SEEK-Academy/sun-sensor-hardware/doc/components/PCB 50x70 v3 (2).png

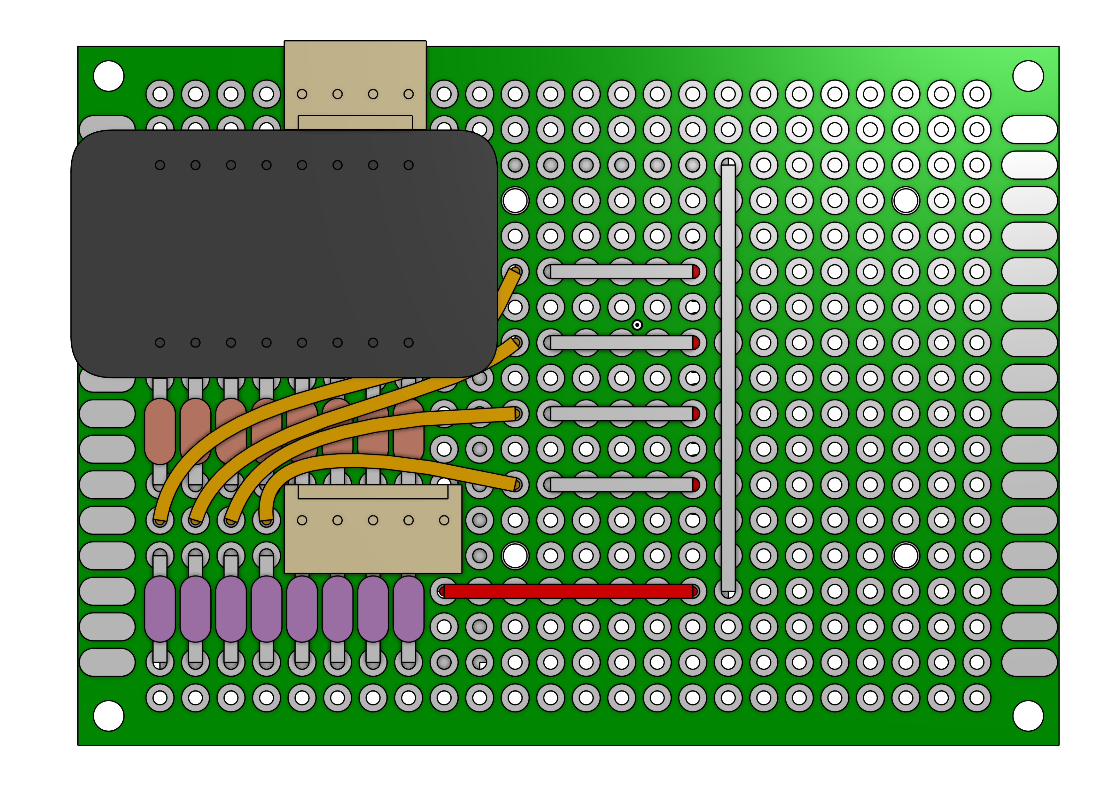
doc/components/PCB 50x70 v3 (2).png
