SEEK-Academy/sun-sensor-hardware/doc/components/PCB 40x60 FR v1 (2).png

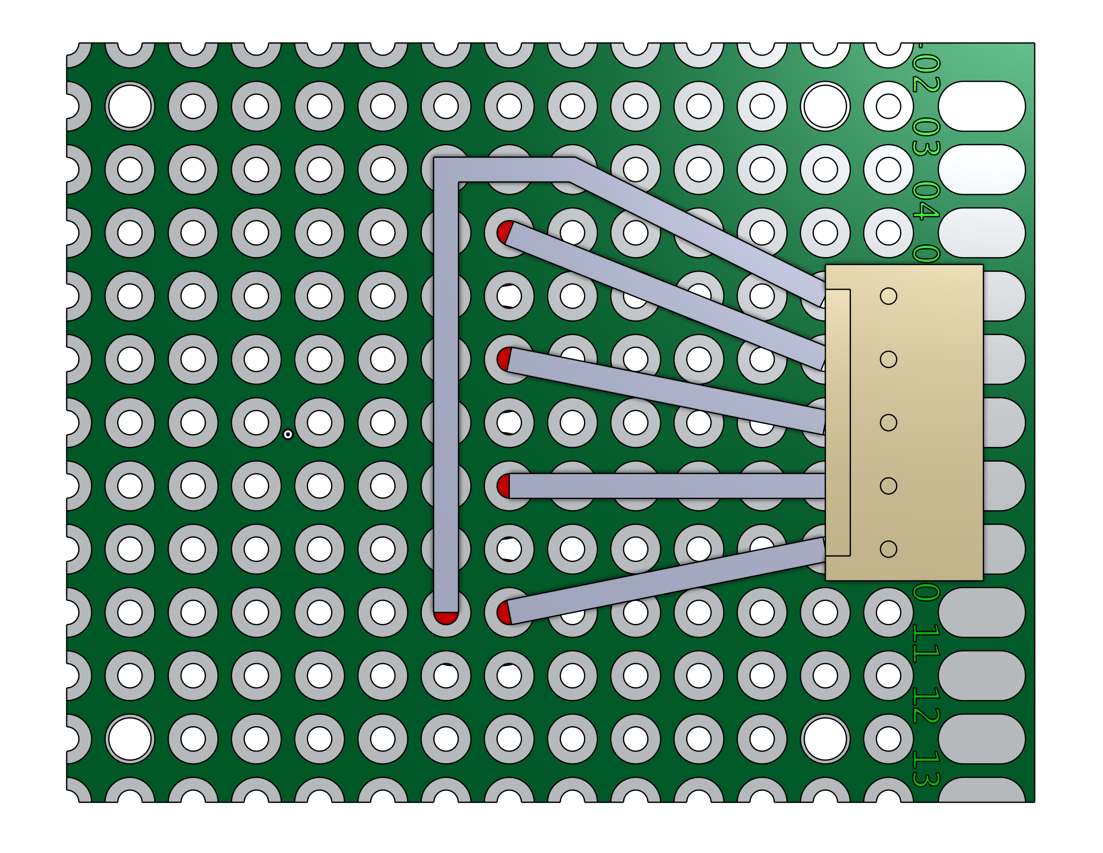
doc/components/PCB 40x60 FR v1 (2).png
