SEEK-Academy/sun-sensor-hardware/doc/3D_models/Calculation.xlsx

Sheet: Face
VERSION 2-3
Name | Symbol | Value | Unit |  |  |  | Photoresistor | From | Center | To | Unit
sensor length | Lp | 4.5 | mm |  |  |  | 1 | -9 | -6.75 | -4.5 | mm
sensor width | Wp | 5.2 | mm |  |  |  | 2 | -4.5 | -2.25 | 0 | mm
sensor number | N | 4 | pieces |  |  |  | 3 | 0 | 2.25 | 4.5 | mm
sensor array length | L | 18 | mm |  |  |  | 4 | 4.5 | 6.75 | 9 | mm
maximum distance from center to edge of array | dmax | 9 | mm
space between array and slit | h | 9 | mm
slit length | b | 18 | mm
slit width | a | 6.75 | mm
slit height | c | 0.2 | mm | < | 6.75 | mm
VERSION 4-…
Name | Symbol | Value | Unit |  |  |  | Photoresistor | From | Center | To | Unit
sensor length | Lp | 4.5 | mm |  |  |  | 1 | -9 | -6.75 | -4.5 | mm
sensor width | Wp | 5.2 | mm |  |  |  | 2 | -4.5 | -2.25 | 0 | mm
sensor number | N | 4 | pieces |  |  |  | 3 | 0 | 2.25 | 4.5 | mm
sensor array length | L | 18 | mm |  |  |  | 4 | 4.5 | 6.75 | 9 | mm
maximum distance from center to edge of array | dmax | 9 | mm
space between array and slit | h | 9 | mm |  |  |  | Bolt size | Size | Length S | Length L | Unit
slit length | b | 18 | mm |  |  |  | - | M3 | 10 | 20 | mm
slit width | a | 5.4 | mm |  |  |  | Nut size | Borders | Height | Width | Length | Unit
slit height | c | 0.2 | mm | < | 5.4 | mm | - | 6 | 2.4 | 5.4 | 6 | mm
VERSION 8-…
Name | Symbol | Value | Unit |  |  |  | Photoresistor | From | Center | To | Unit |  | Board raster | unit |  | Value | Unit
sensor length (max) | Lp | 4.5 | mm |  |  |  | 1 | -9.87 | -7.62 | -5.37 | mm |  | 2.54 | mm | Face height | 2 | mm
sensor width (max) | Wp | 5.2 | mm |  |  |  | 2 | -4.79 | -2.54 | -0.29 | mm |  |  |  | Separator slot | 0.4 | mm
sensor number | N | 4 | pieces |  |  |  | 3 | 0.29 | 2.54 | 4.79 | mm |  |  |  | Separator height | 10.57 | mm
sensor array length | L | 19.74 | mm |  |  |  | 4 | 5.37 | 7.62 | 9.87 | mm |  | Sensor height (avg) | unit | From face bottom to array | 7.87 | mm
maximum distance from center to edge of array | dmax | 9.87 | mm |  |  |  |  |  |  |  |  |  | 2.1 | mm | From face bottom to board | 10.17 | mm
space between array and slit | h | 9.87 | mm |  |  |  | Bolt size | Size | Length | Width | Unit |  | Sensor spacing to board |  | From separator slot to array | 7.47 | mm
slit length | b | 19.74 | mm |  |  |  | - | M1.6 | 16 | 1.3 | mm |  | 0.2 | mm | From separator slot to board | 9.77 | mm
slit width | a | 3.6 | mm |  |  |  | Nut size | Borders | Height | Width | Length | Unit | Sensor height to board |  | From face top to array | 9.87 | mm
slit height | c | 0.2 | mm | < | 2.222530646 | mm | - | 6 | 1.1 | 3 | 3.4 | mm | 2.3 | mm | From face top to board | 12.17 | mm

Sheet: Platform
VERSION 1-…
Circuit board |  |  | Spacing bettwen Circuit board and Platform slit |  |  |  | Platform slit |  |  | Circuit board support stand |  |  |  |  | Empty slit
Dimension | Value | Unit | Projection | Site | Value | Unit | Dimension | Value | Unit | Projection | Site | Value | Unit |  | Dimension | Value | Unit
Length | 51 | mm | Top | Top | 1 | mm | Length | 53 | mm | Top | Top | 0 | mm |  | Length | 51 | mm
Width | 51 | mm | Top | Bottom | 1 | mm | Width | 53 | mm | Top | Bottom | 0 | mm |  | Width | 48.6 | mm
Height | 1.2 | mm | Top | Right | 1 | mm | Height | 1.2 | mm | Top | Right | 1.2 | mm |  | Height | - | mm
 |  |  | Top | Left | 1 | mm |  |  |  | Top | Left | 1.2 | mm
 |  |  | Front | Top | 0 | mm
 |  |  | Front | Bottom | 0 | mm
VERSION 3-…
Circuit board |  |  | Spacing bettwen Circuit board and Platform slit |  |  |  | Platform slit |  |  | Circuit board support stand |  |  |  | Platform board thickness |  |  |  | Platform size
Dimension | Value | Unit | Projection | Site | Value | Unit | Dimension | Value | Unit | Dimension | Value | Unit |  | Projection | Site | Value | Unit | Dimension | Value | Unit
Length | 54 | mm | Top | Top | 0 | mm | Length | 54 | mm | Height | 0.8 | mm |  | Top | Top | 1 | mm | Length | 56 | mm
Width | 51 | mm | Top | Bottom | 0 | mm | Width | 51 | mm | grid pattern |  |  |  | Top | Bottom | 1 | mm | Width | 56 | mm
Height | 1.2 | mm | Top | Right | 0 | mm | Height | 1.2 | mm |  |  |  |  | Top | Right | 2.5 | mm | Height | 1.2 | mm
 |  |  | Top | Left | 0 | mm |  |  |  |  |  |  |  | Top | Left | 2.5 | mm
 |  |  | Front | Top | 0 | mm
 |  |  | Front | Bottom | 0 | mm
VERSION 4-…
Circuit board |  |  | Spacing bettwen Circuit board and Platform slit |  |  |  | Platform slit |  |  | Circuit board support stand |  |  |  | Platform board thickness |  |  |  | Platform size
Dimension | Value | Unit | Projection | Site | Value | Unit | Dimension | Value | Unit | Dimension | Value | Unit |  | Projection | Site | Value | Unit | Dimension | Value | Unit
Length | 54 | mm | Top | Top | 0 | mm | Length | 54 | mm | Height | 0.8 | mm |  | Top | Top | 1 | mm | Length | 56 | mm
Width | 50 | mm | Top | Bottom | 0 | mm | Width | 50 | mm | grid pattern mechd with pads |  |  |  | Top | Bottom | 1 | mm | Width | 56 | mm
Height | 1.2 | mm | Top | Right | 0 | mm | Height | 1.2 | mm |  |  |  |  | Top | Right | 3 | mm | Height | 2 | mm
 |  |  | Top | Left | 0 | mm |  |  |  |  |  |  |  | Top | Left | 3 | mm
 |  |  | Front | Top | 0 | mm
 |  |  | Front | Bottom | 0 | mm
