SEEK-Academy/sun-sensor-hardware/doc/3D_models/Comparison of photoresist measurements - 20241130.xlsx

MESUREMENTS |  |  |  |  |  | SOURCE MIN-MAX
package | item | length | width | height | unit |  | length | width | height | unit
1 | 1 | 4.1 | 5 | 1.9 | mm | min | 4.1 | 5 | 1.9 | mm
1 | 2 | 4 | 4.9 | 2 | mm | max | 4.5 | 5.2 | 2.3 | mm
1 | 3 | 4.2 | 5 | 1.9 | mm
2 | 4 | 4.2 | 5 | 2.1 | mm | MESUREMENTS MIN-MAX
2 | 5 | 4.1 | 5 | 2.3 | mm |  | length | width | height | unit
2 | 6 | 4.1 | 4.9 | 2.2 | mm | min | 4 | 4.9 | 1.9 | mm
3 | 7 | 4.2 | 5 | 2.2 | mm | max | 4.3 | 5 | 2.3 | mm
3 | 8 | 4.2 | 5 | 2.1 | mm
3 | 9 | 4.3 | 5 | 2.2 | mm
