SEEK-Academy/sun-sensor-hardware/doc/components/PCB 50x70 v3 (1).png

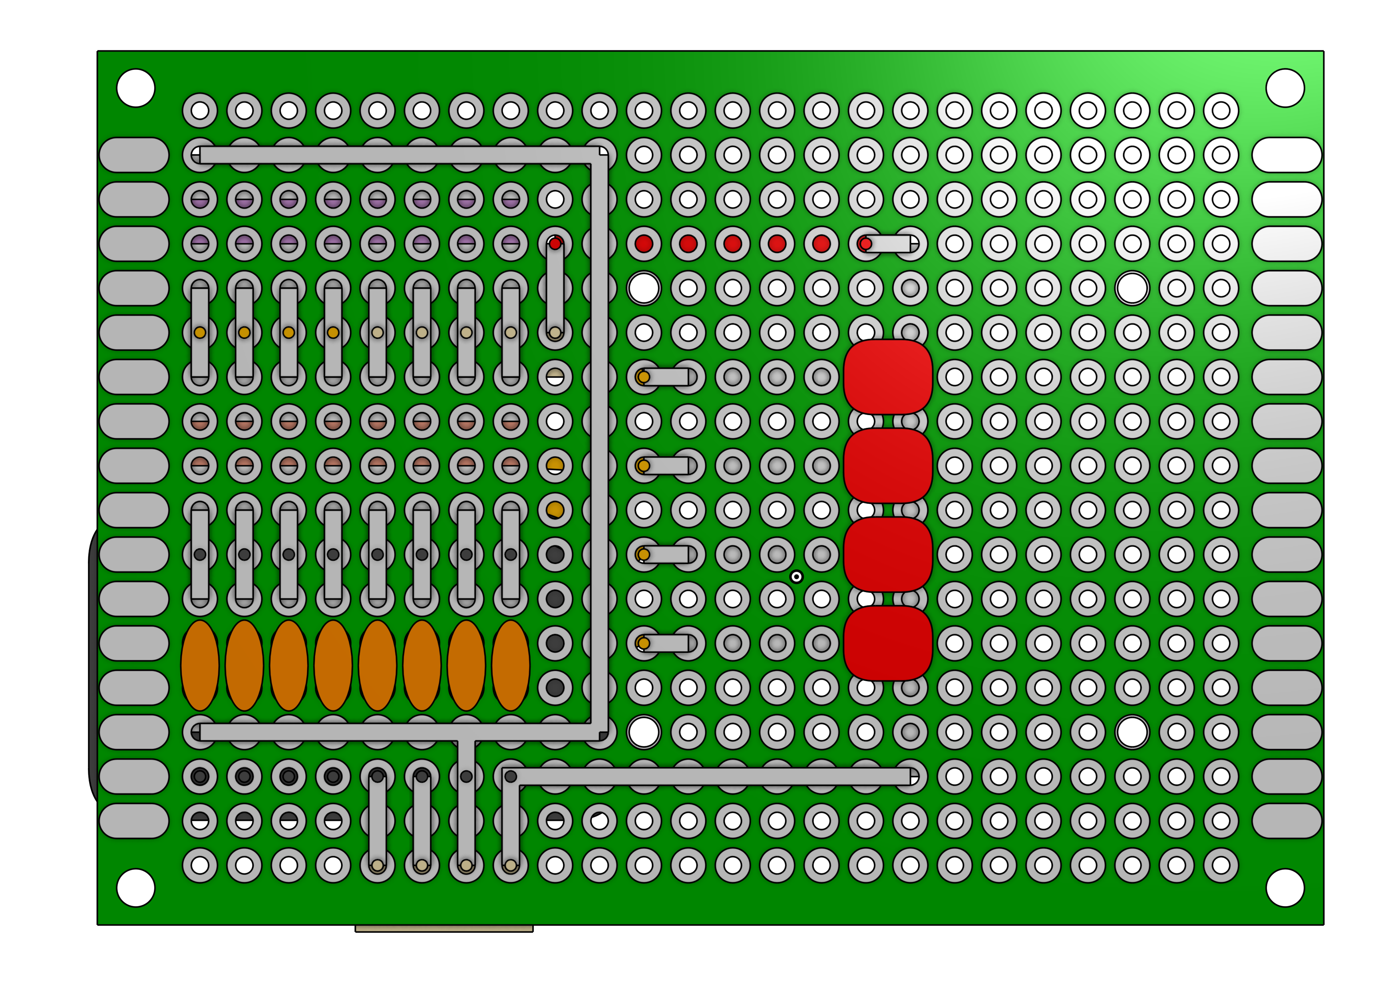
doc/components/PCB 50x70 v3 (1).png
