SEEK-Academy/sun-sensor-hardware/doc/components/PCB 50x70 v3 (2) no ADC.png

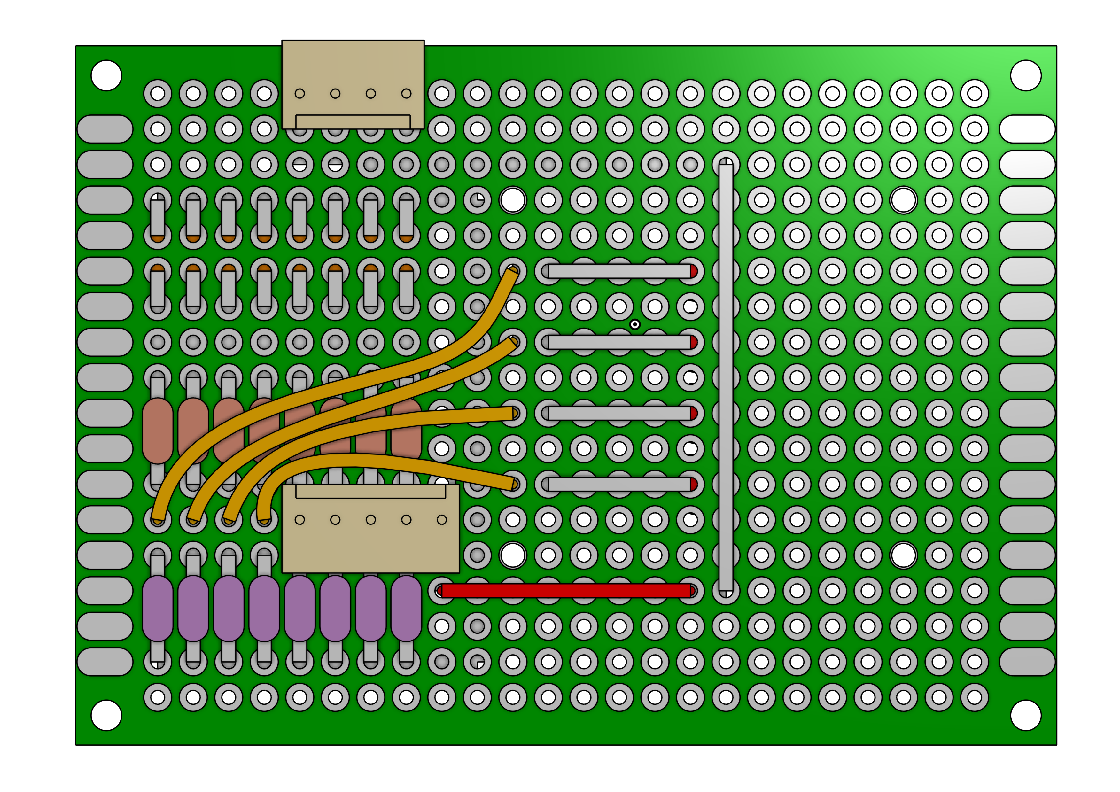
doc/components/PCB 50x70 v3 (2) no ADC.png
