SEEK-Academy/sun-sensor-hardware/doc/components/PCB 50x70 v3 (4).png

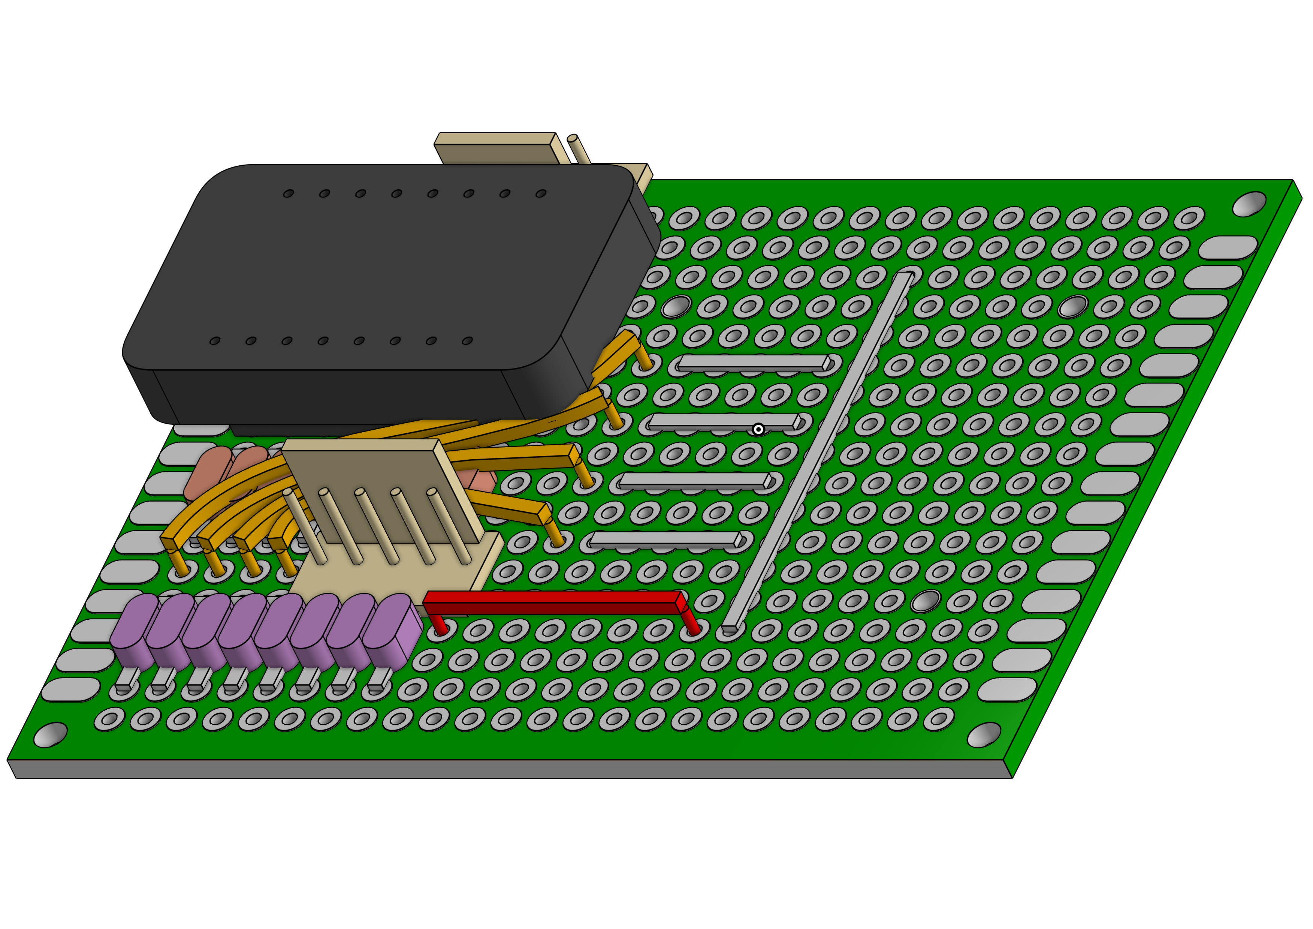
doc/components/PCB 50x70 v3 (4).png
