SEEK-Academy/sun-sensor-hardware/doc/components/PCB 60x80 STM v1 (1).png

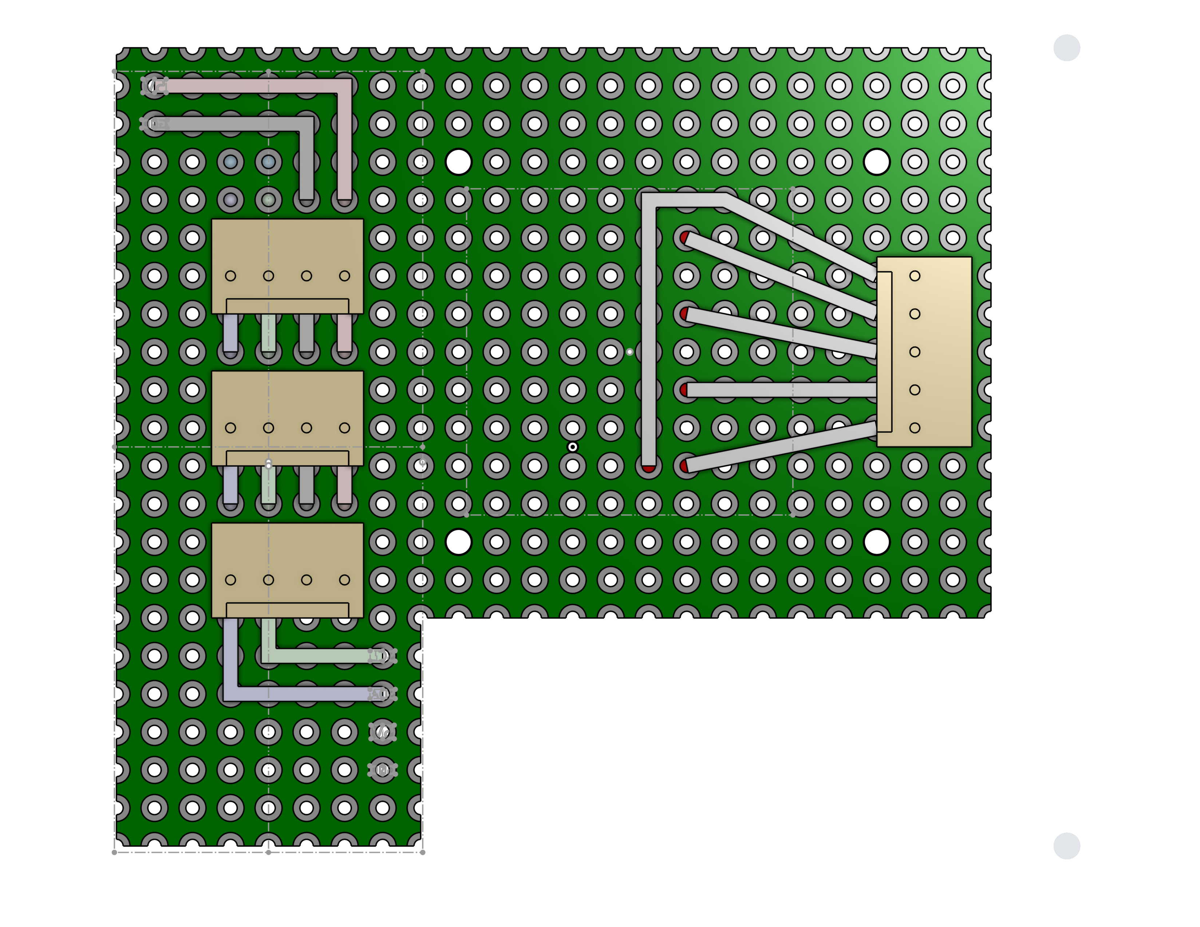
doc/components/PCB 60x80 STM v1 (1).png
