SEEK-Academy/sun-sensor-hardware/doc/3D_models/assemblies/Assembly - 3 faces.stl

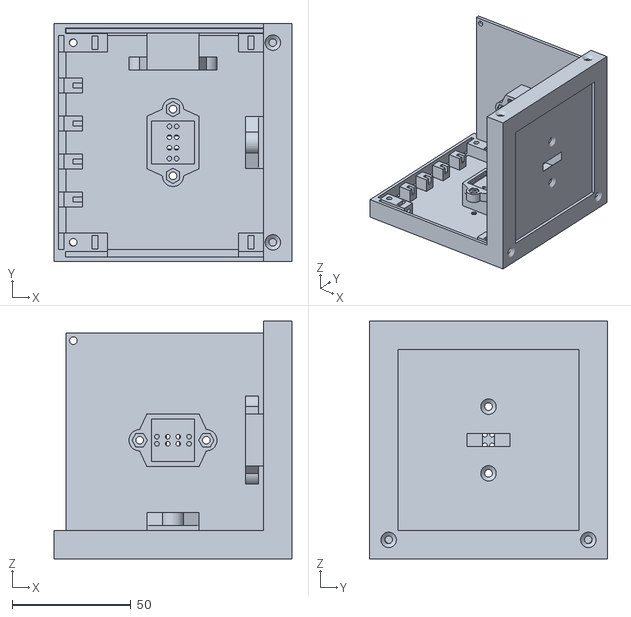
[picture p10: CAD file, 2025-03-29]
doc/3D_models/assemblies/Assembly - 3 faces.stl
100.0 x 100.0 x 100.0
