SEEK-Academy/sun-sensor-hardware/doc/3D_models/assemblies/Assembly - 3 faces and platforms.stl

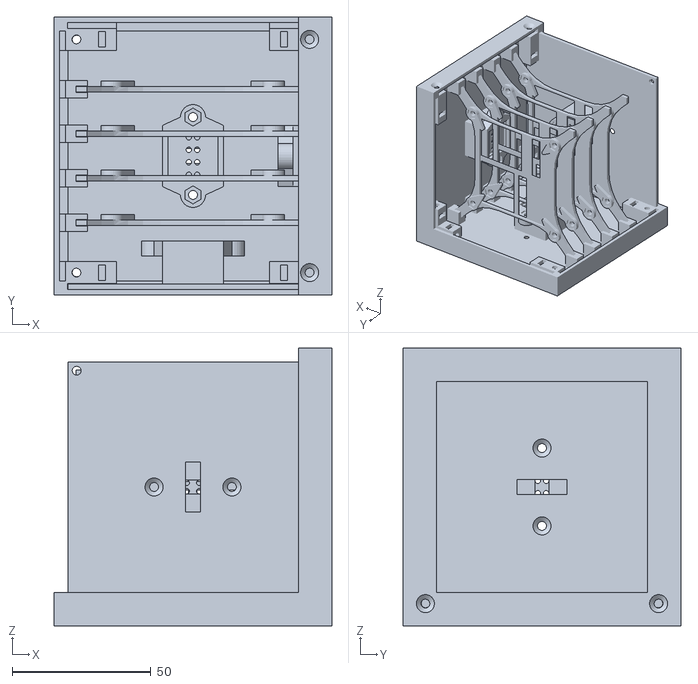
[picture p11: CAD file, 2025-03-29]
doc/3D_models/assemblies/Assembly - 3 faces and platforms.stl
100.0 x 100.0 x 100.0
