SEEK-Academy/sun-sensor-hardware/doc/3D_models/frame_cup/v3/SunSensor - frame cup v3.3mf

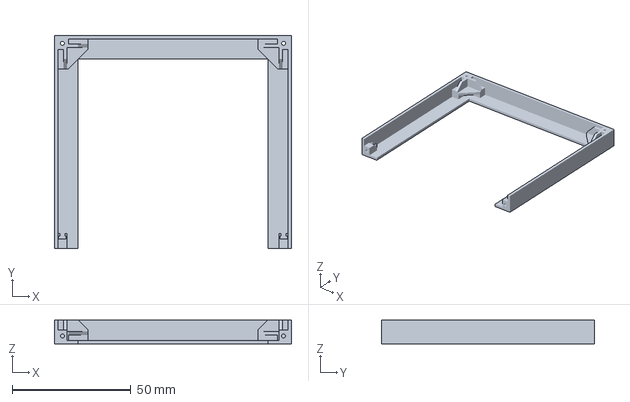
[picture p12: CAD file, 2026-03-20]
doc/3D_models/frame_cup/v3/SunSensor - frame cup v3.3mf
100.0 x 90.0 x 10.0 mm
