SEEK-Academy/sun-sensor-hardware/doc/3D_models/frame_stick/v4/SunSensor - frame stick lid v4_horizontal.3mf

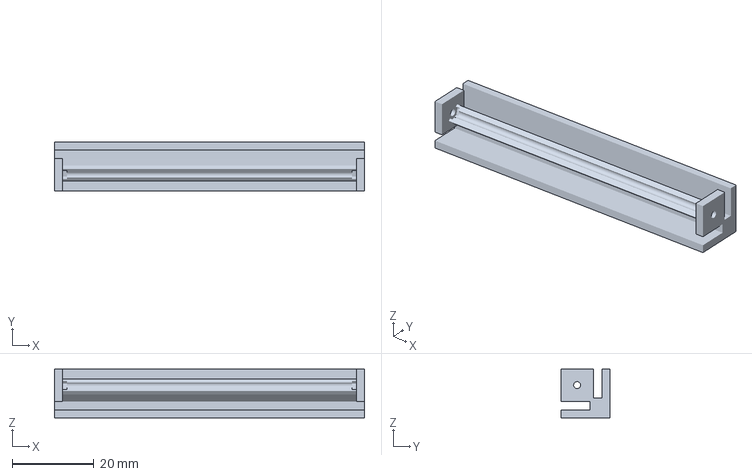
[picture p13: CAD file, 2025-06-09]
doc/3D_models/frame_stick/v4/SunSensor - frame stick lid v4_horizontal.3mf
76.0 x 12.0 x 12.0 mm
