SEEK-Academy/sun-sensor-hardware/doc/3D_models/holder/v1/SunSensor - holder v1.3mf

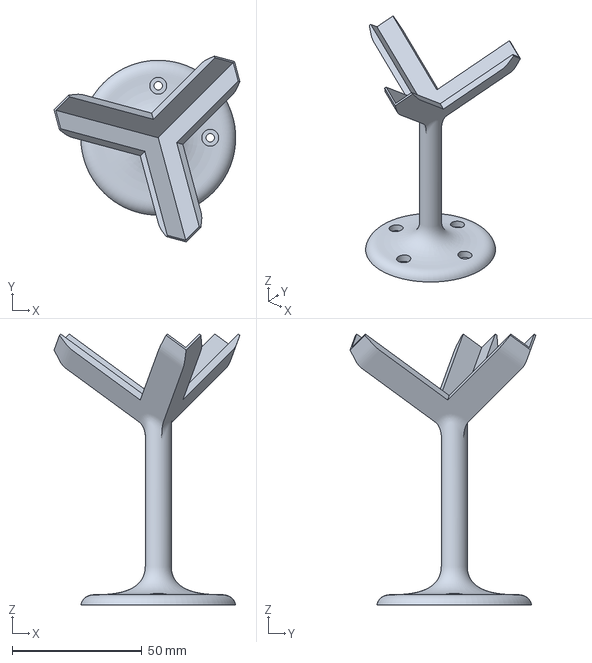
[picture p14: CAD file, 2026-03-20]
doc/3D_models/holder/v1/SunSensor - holder v1.3mf
71.5 x 71.5 x 104.3 mm
