SEEK-Academy/sun-sensor-hardware/doc/3D_models/internal_platform/v4/SunSensor - internal platform V4 - Platform - slice1.3mf

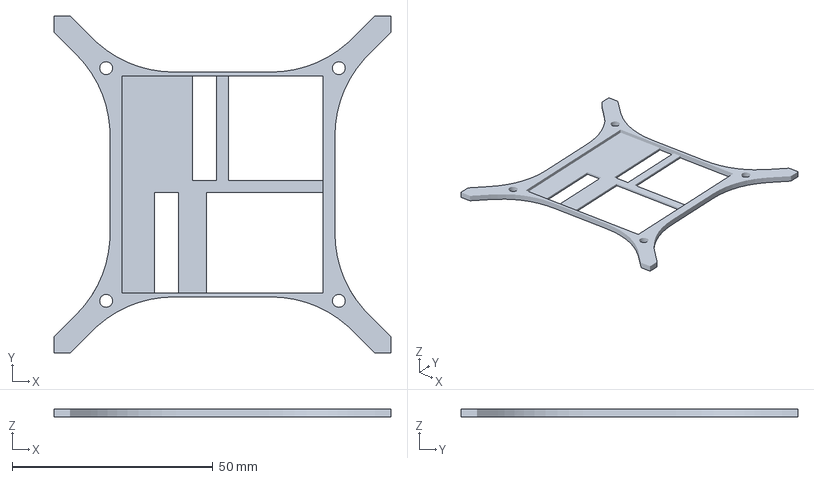
[picture p15: CAD file, 2025-02-18]
doc/3D_models/internal_platform/v4/SunSensor - internal platform V4 - Platform - slice1.3mf
84.0 x 84.0 x 2.00 mm
