SEEK-Academy/sun-sensor-hardware/doc/3D_models/pcb/SunSensor - PCB 50x70 v2 tester.3mf

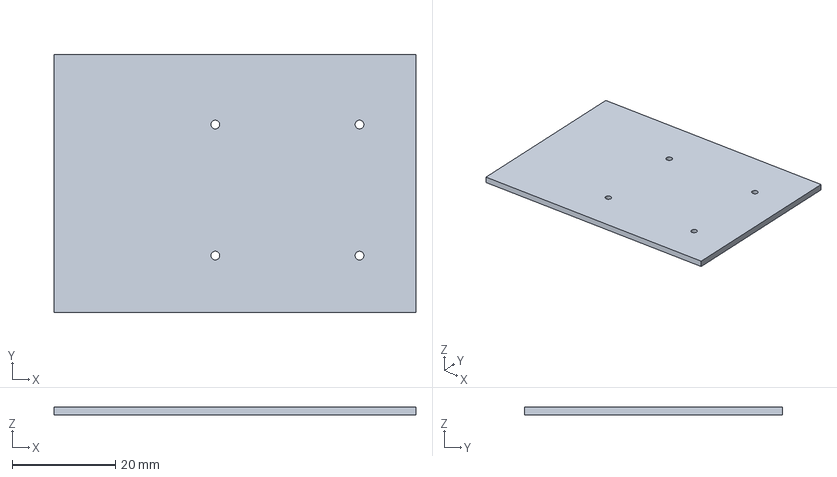
[picture p16: CAD file, 2025-07-15]
doc/3D_models/pcb/SunSensor - PCB 50x70 v2 tester.3mf
70.2 x 50.0 x 1.60 mm
