SEEK-Academy/sun-sensor-hardware/doc/3D_models/slit_sensor_face/v11/SunSensor - slit sensor face v11 - Separator.3mf

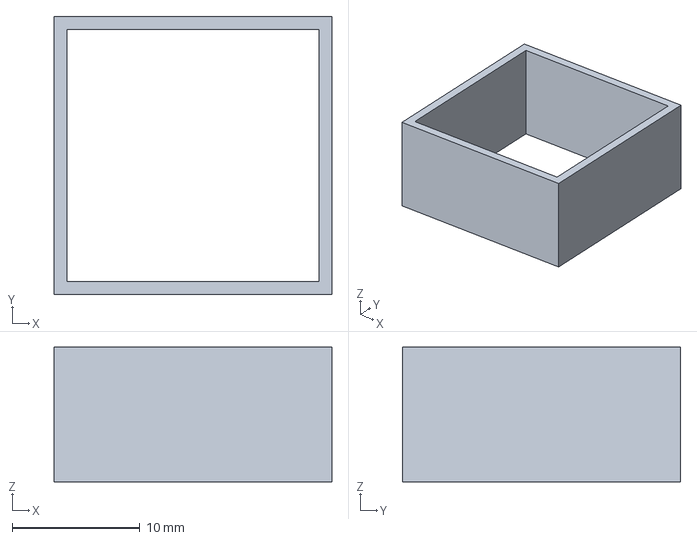
[picture p17: CAD file, 2026-03-20]
doc/3D_models/slit_sensor_face/v11/SunSensor - slit sensor face v11 - Separator.3mf
21.8 x 21.8 x 10.6 mm
