SEEK-Academy/sun-sensor-hardware/doc/3D_models/slit_sensor_face_lid/v1/SunSensor - slit sensor face lid V1 - Face.3mf

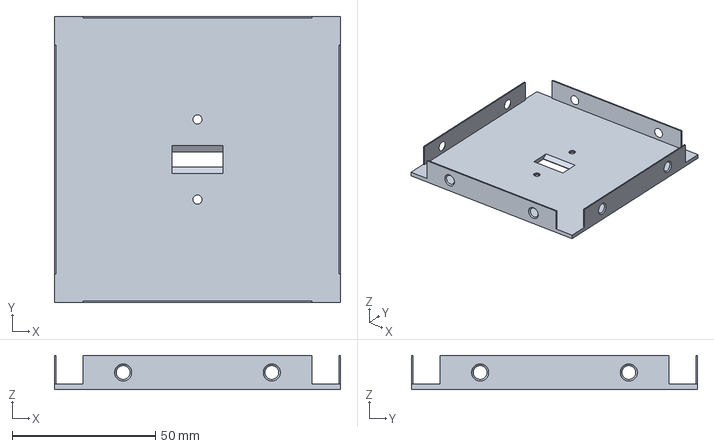
[picture p18: CAD file, 2024-12-18]
doc/3D_models/slit_sensor_face_lid/v1/SunSensor - slit sensor face lid V1 - Face.3mf
100.0 x 100.0 x 12.0 mm
