SEEK-Academy/sun-sensor-hardware/doc/3D_models/internal_platform/v4/SunSensor - internal platform V4 - Stabilizator.stl

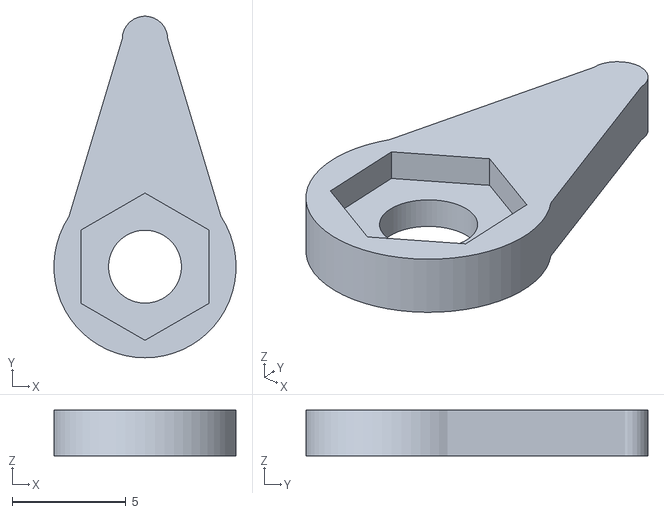
[picture p19: CAD file, 2025-02-18]
doc/3D_models/internal_platform/v4/SunSensor - internal platform V4 - Stabilizator.stl
7.99 x 15.0 x 2.00
