SEEK-Academy/sun-sensor-hardware/doc/3D_models/pcb/SunSensor - PCB 46x61 tester.3mf

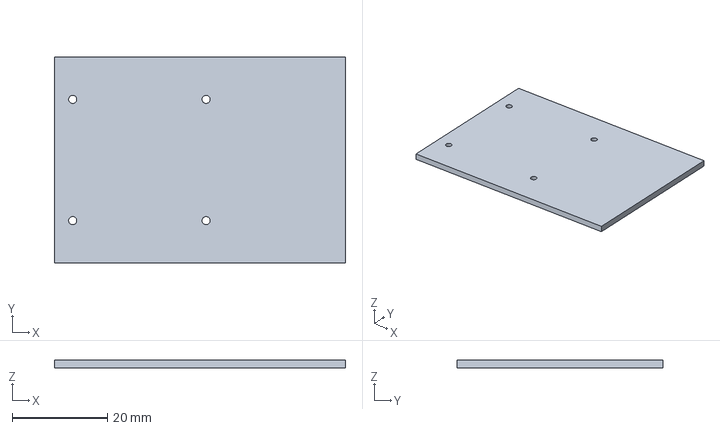
[picture p20: CAD file, 2025-06-21]
doc/3D_models/pcb/SunSensor - PCB 46x61 tester.3mf
61.0 x 43.2 x 1.60 mm
