SEEK-Academy/sun-sensor-hardware/doc/3D_models/slit_sensor_face/v11/SunSensor - slit sensor face v11 - Face.3mf

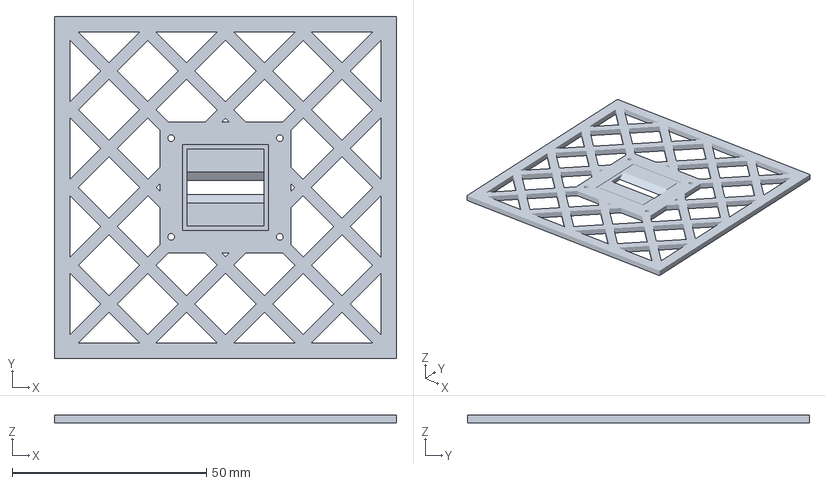
[picture p21: CAD file, 2026-03-20]
doc/3D_models/slit_sensor_face/v11/SunSensor - slit sensor face v11 - Face.3mf
88.0 x 88.0 x 2.00 mm
