SEEK-Academy/sun-sensor-hardware/doc/3D_models/frame_stick/v4/SunSensor - frame stick v4.3mf

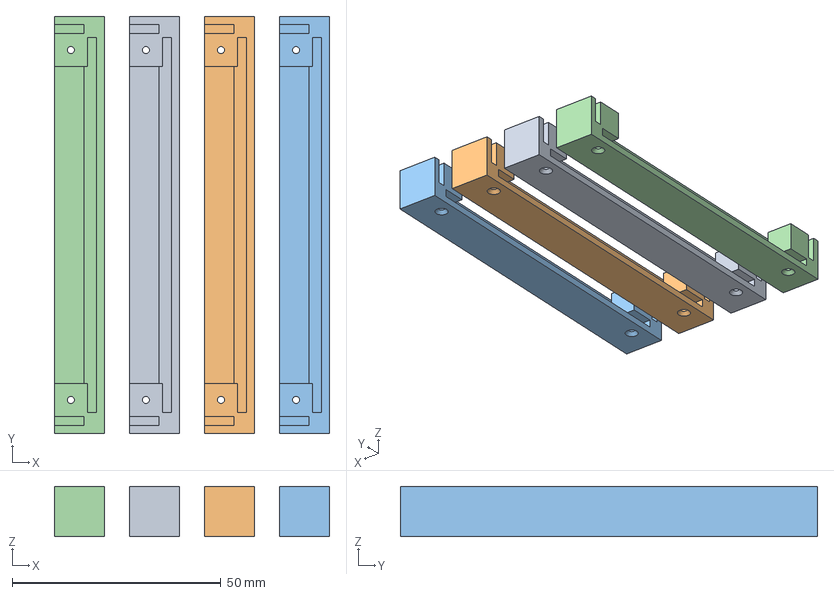
[picture p22: CAD file, 2025-06-09]
doc/3D_models/frame_stick/v4/SunSensor - frame stick v4.3mf
66.0 x 100.0 x 12.0 mm
SunSensor - frame stick v4.stl x 4
