SEEK-Academy/sun-sensor-hardware/(list of files, cad)

Other CAD files:
doc/3D_models/frame_stick/v4/SunSensor - frame stick lid v4_detail_gpt.3mf
doc/3D_models/internal_platform/v4/SunSensor - internal platform V4 - Platform.stl
doc/3D_models/frame_stick/v4/SunSensor - frame stick lid v4.stl
doc/3D_models/frame_stick/v4/SunSensor - frame stick lid v4_detail_standard.3mf
doc/3D_models/frame_stick/v4/SunSensor - frame stick lid v4_horizontal_supports.3mf
doc/3D_models/frame_cup/v1/SunSensor - frame cup v1.3mf
doc/3D_models/frame_cup/v1/SunSensor - frame cup v1.stl
doc/3D_models/frame_cup/v2/SunSensor - frame cup v2.3mf
doc/3D_models/frame_cup/v2/SunSensor - frame cup v2.stl
doc/3D_models/frame_stick/v1/SunSensor - frame stick V1 - All parts.3mf
doc/3D_models/frame_stick/v1/SunSensor - frame stick V1 - Stick.3mf
doc/3D_models/frame_stick/v2/SunSensor - frame stick V2 - All parts.3mf
doc/3D_models/frame_stick/v2/SunSensor - frame stick V2 - Stick Lid.3mf
doc/3D_models/frame_stick/v2/SunSensor - frame stick V2 - Stick.3mf
doc/3D_models/frame_stick/v3/SunSensor - frame stick V3 - All parts.3mf
doc/3D_models/frame_stick/v3/SunSensor - frame stick V3 - Stick Lid.3mf
doc/3D_models/frame_stick/v3/SunSensor - frame stick V3 - Stick.3mf
doc/3D_models/frame_stick/v4/SunSensor - frame stick v4.stl
doc/3D_models/holder/v1/SunSensor - holder v1.stl
doc/3D_models/internal_platform/v1/SunSensor - internal platform V1 - Platform.3mf
doc/3D_models/internal_platform/v2/SunSensor - internal platform V2 - All parts.3mf
doc/3D_models/internal_platform/v2/SunSensor - internal platform V2 - Platform.3mf
doc/3D_models/internal_platform/v2/SunSensor - internal platform V2 - Stabilizator.3mf
doc/3D_models/internal_platform/v3/SunSensor - internal platform V3 - Platform - slicer.3mf
doc/3D_models/internal_platform/v3/SunSensor - internal platform V3 - Platform.3mf
doc/3D_models/internal_platform/v3/SunSensor - internal platform V3 - Stabilizator.3mf
doc/3D_models/pcb/SunSensor - PCB 46x61 tester.stl
doc/3D_models/pcb/SunSensor - PCB 50x70 tester.3mf
doc/3D_models/pcb/SunSensor - PCB 50x70 tester.stl
doc/3D_models/pcb/SunSensor - PCB 50x70 v2 tester.stl
doc/3D_models/slit_sensor_face/v1/SunSensor - slit sensor face V1 - Face.3mf
doc/3D_models/slit_sensor_face/v1/SunSensor - slit sensor face V1 - Sensor array.3mf
doc/3D_models/slit_sensor_face/v10/SunSensor - slit sensor face v10 - Face.3mf
doc/3D_models/slit_sensor_face/v10/SunSensor - slit sensor face v10 - Face.stl
doc/3D_models/slit_sensor_face/v10/SunSensor - slit sensor face v10 - Separator.3mf
doc/3D_models/slit_sensor_face/v10/SunSensor - slit sensor face v10 - Separator.stl
doc/3D_models/slit_sensor_face/v2/SunSensor - slit sensor face V2 - Face.3mf
doc/3D_models/slit_sensor_face/v2/SunSensor - slit sensor face V2 - Face.stl
doc/3D_models/slit_sensor_face/v2/SunSensor - slit sensor face V2 - Sensor array.3mf
doc/3D_models/slit_sensor_face/v2/SunSensor - slit sensor face V2 - Sensor array.stl
doc/3D_models/slit_sensor_face/v3/SunSensor - slit sensor face V3 - Face.3mf
doc/3D_models/slit_sensor_face/v3/SunSensor - slit sensor face V3 - Sensor array.3mf
doc/3D_models/slit_sensor_face/v4/SunSensor - slit sensor face V4 - Face.3mf
doc/3D_models/slit_sensor_face/v4/SunSensor - slit sensor face V4 - Sensor array.3mf
doc/3D_models/slit_sensor_face/v5/SunSensor - slit sensor face V5 - Face.3mf
doc/3D_models/slit_sensor_face/v5/SunSensor - slit sensor face V5 - Sensor array.3mf
doc/3D_models/slit_sensor_face/v6/SunSensor - slit sensor face V6 - Face.3mf
doc/3D_models/slit_sensor_face/v6/SunSensor - slit sensor face V6 - Mount Separation Bottom.3mf
doc/3D_models/slit_sensor_face/v6/SunSensor - slit sensor face V6 - Mount Separation Top.3mf
doc/3D_models/slit_sensor_face/v6/SunSensor - slit sensor face V6 - Sensor array.3mf
doc/3D_models/slit_sensor_face/v6/SunSensor - slit sensor face V6 - all parts.3mf
doc/3D_models/slit_sensor_face/v7/SunSensor - slit sensor face V7 - All parts.3mf
doc/3D_models/slit_sensor_face/v7/SunSensor - slit sensor face V7 - Face.3mf
doc/3D_models/slit_sensor_face/v7/SunSensor - slit sensor face V7 - Mount Separation Bottom.3mf
doc/3D_models/slit_sensor_face/v7/SunSensor - slit sensor face V7 - Mount Separation Top.3mf
doc/3D_models/slit_sensor_face/v7/SunSensor - slit sensor face V7 - Sensor array.3mf
doc/3D_models/slit_sensor_face/v8/SunSensor - slit sensor face v8 - Face.3mf
doc/3D_models/slit_sensor_face/v8/SunSensor - slit sensor face v8 - Face.stl
doc/3D_models/slit_sensor_face/v8/SunSensor - slit sensor face v8 - Separator.3mf
doc/3D_models/slit_sensor_face/v9/SunSensor - slit sensor face v9 - Face.3mf
doc/3D_models/slit_sensor_face/v9/SunSensor - slit sensor face v9 - Face.stl
doc/3D_models/washer/Washer M1.8 6x0.4mm (30 psc.).3mf
doc/3D_models/washer/Washer M1.8 6x0.4mm.3mf
doc/3D_models/washer/Washer M1.8 6x0.4mm.stl
