SEEK-Academy/sun-sensor-hardware/(threads)

Thread 13 (2025-01-23):

Klasy abstrakcji sprzętowej

wiQ1999, 2025-01-23:
- Klasa interfejsu - UART (lub USB, bo nie mamy przejściówki aktualnie)
- Klasa interfejsu - I2C
- Klasa DMA

Thread 15 (2025-01-23):

Klasy główne algorytmu

wiQ1999, 2025-01-23:
- Klasa przetwarzania ADC na kąt dla danej sekcji (“ADC Chanel IN, Angle out”)
- Klasa generowania progu aktywacji
- Klasa filtrów DSP
- Klasa analizy płaszczyzn
