SEEK-Academy/sun-sensor-hardware/doc/components/sch-sunsensor-v2.pdf

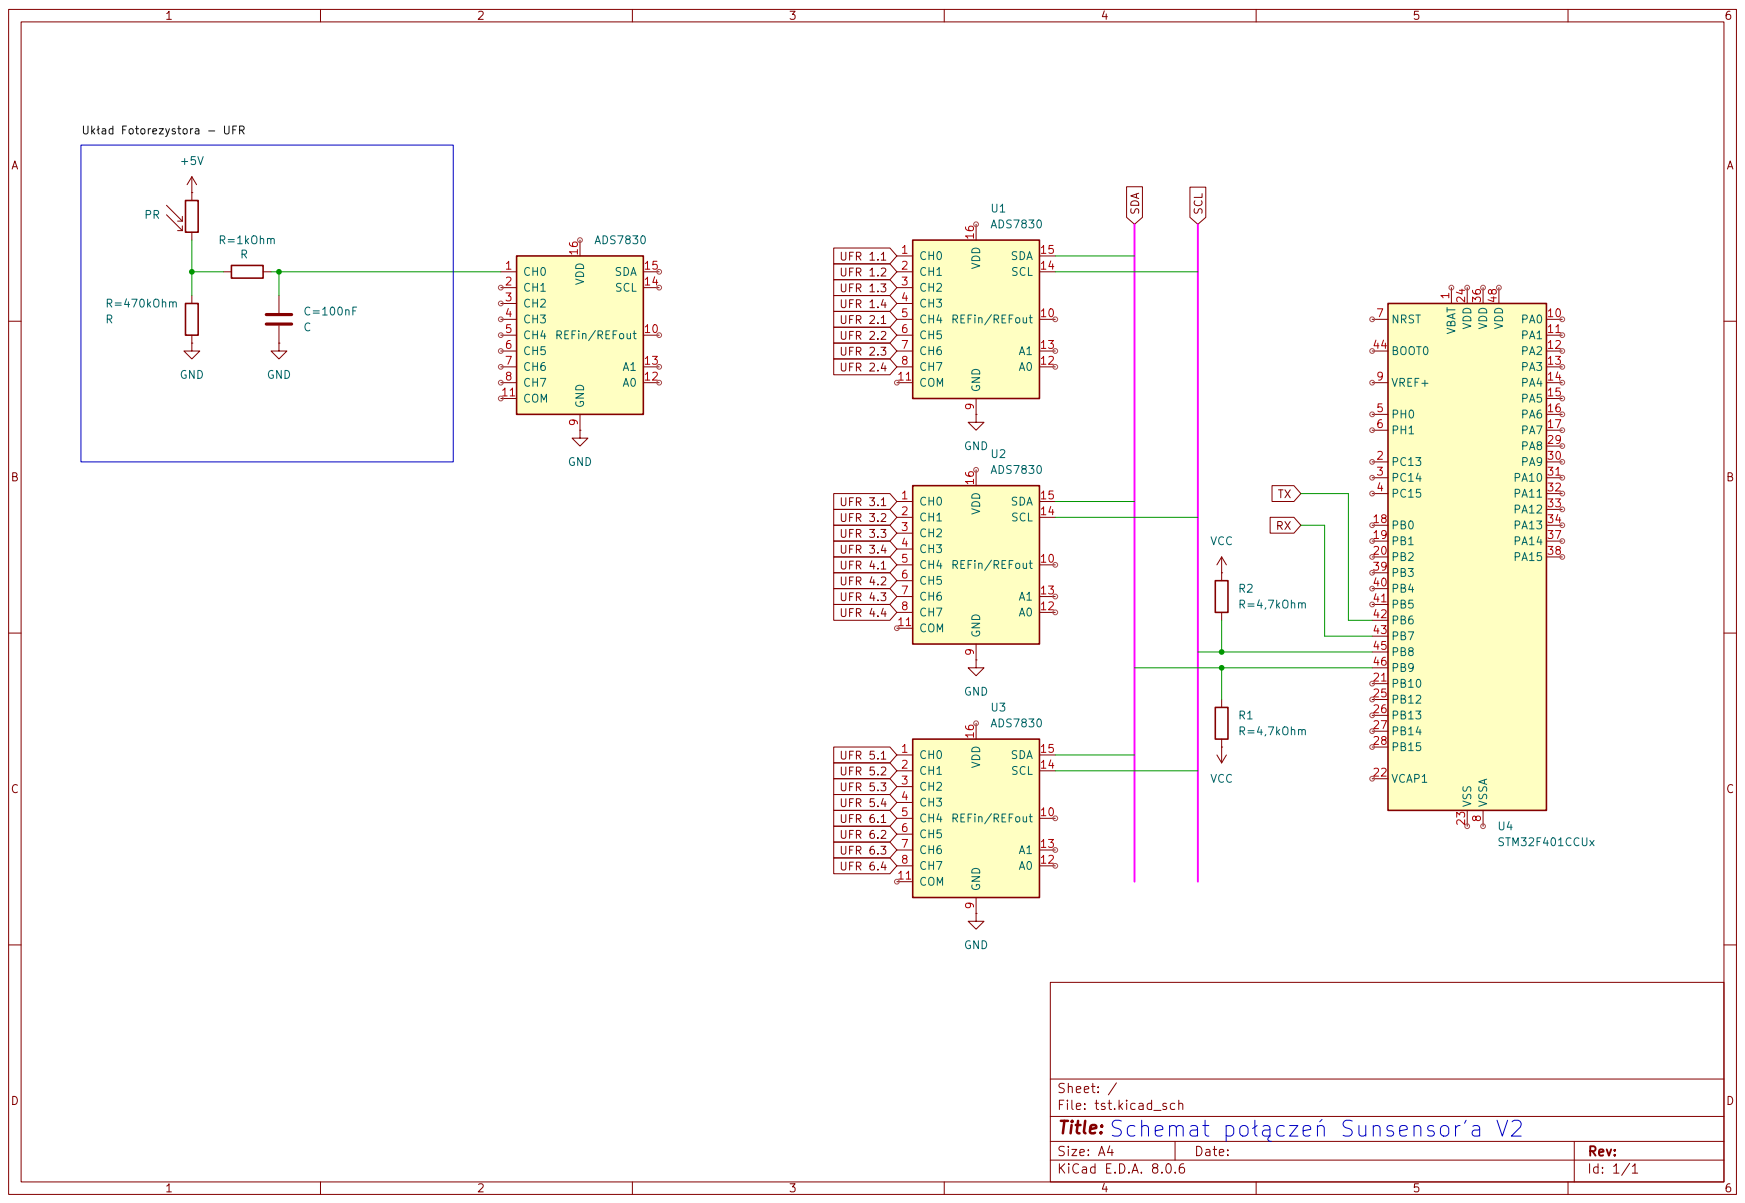
[picture p23: page 1]
