SEEK-Academy/sun-sensor-hardware/doc/3D_models/slit_sensor_face/drawings/SunSesnor Drawing - face and sensor array.pdf

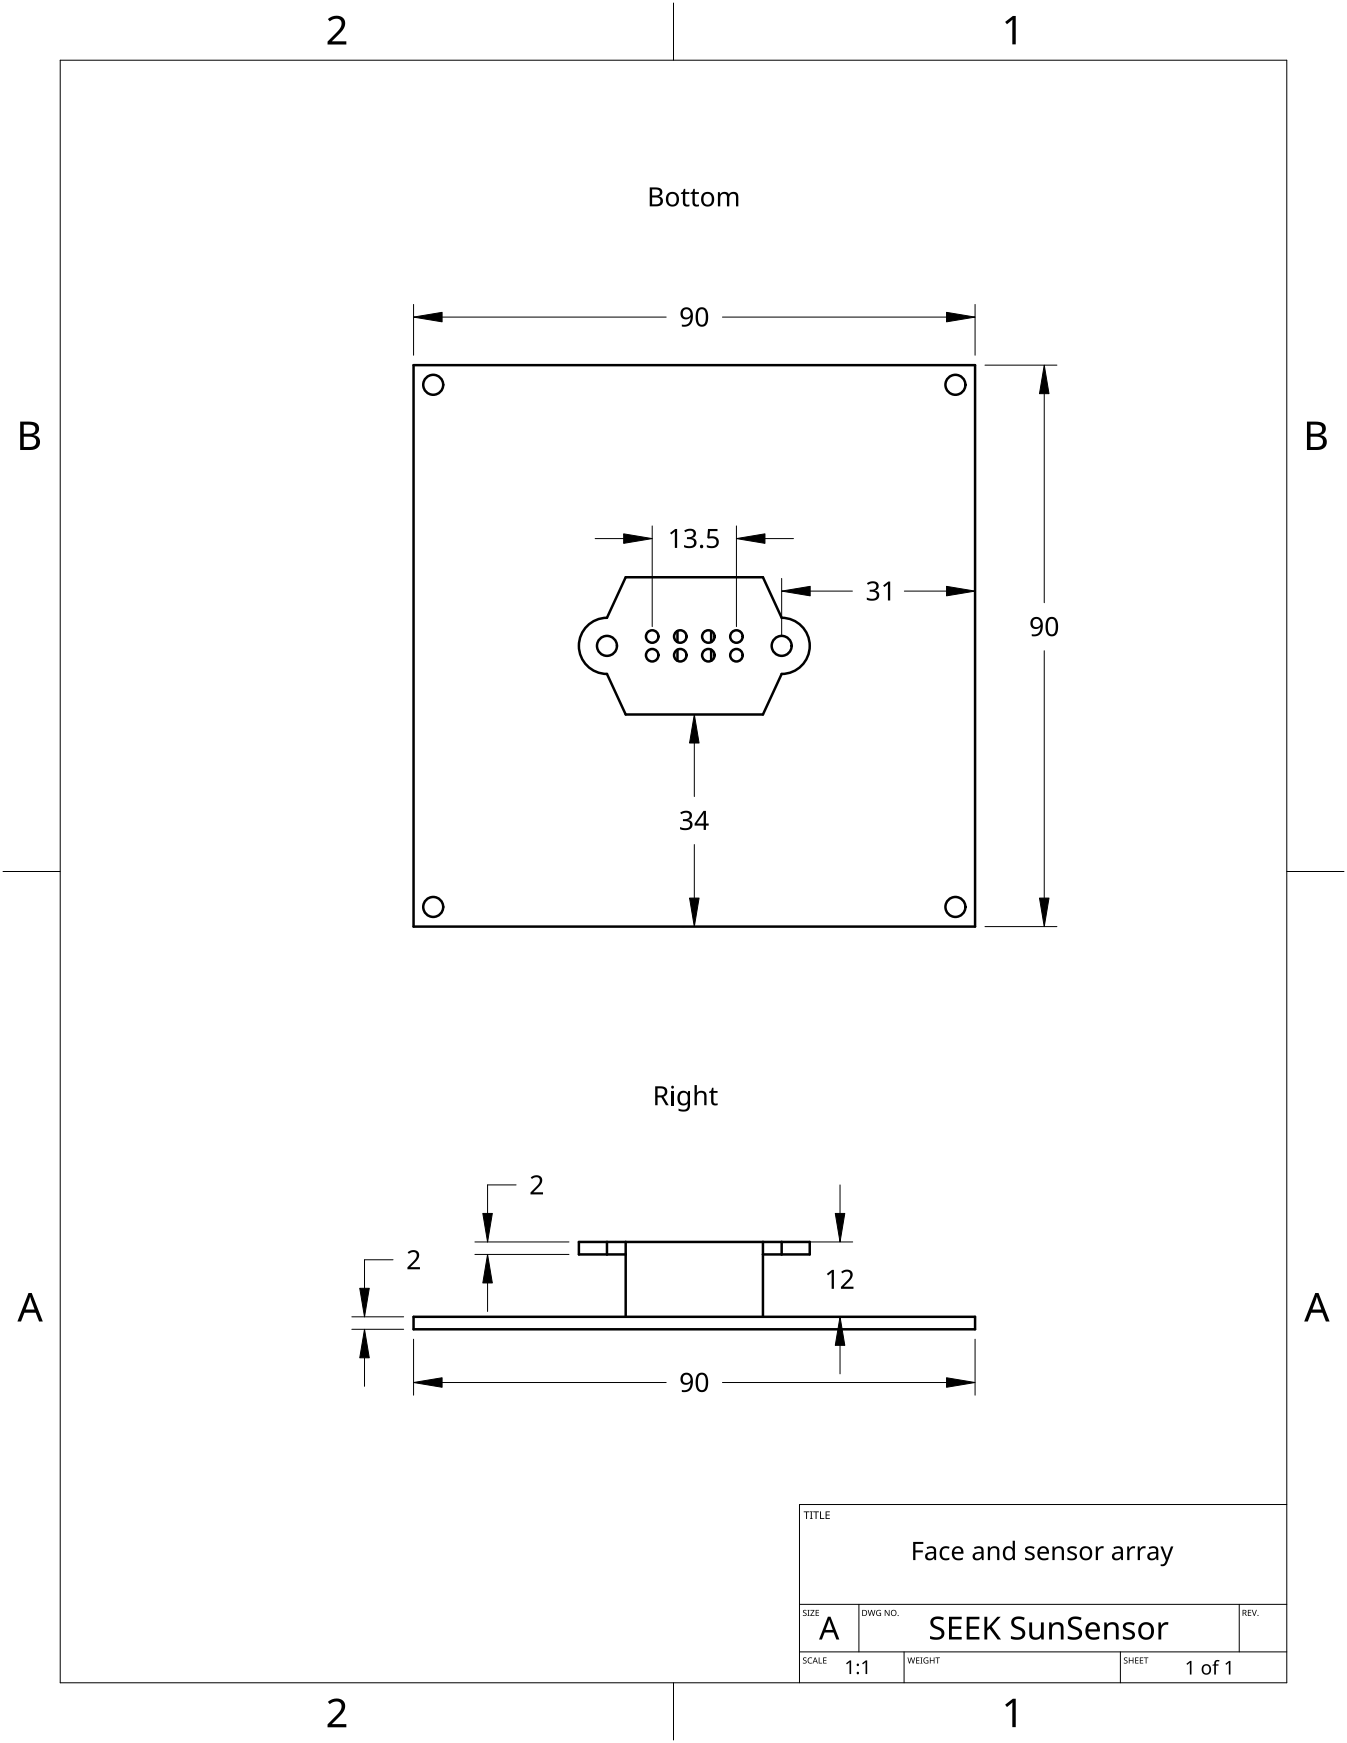
[picture p24: page 1]
