SEEK-Academy/sun-sensor-hardware/doc/3D_models/slit_sensor_face/drawings/SunSesnor Drawing - face.pdf

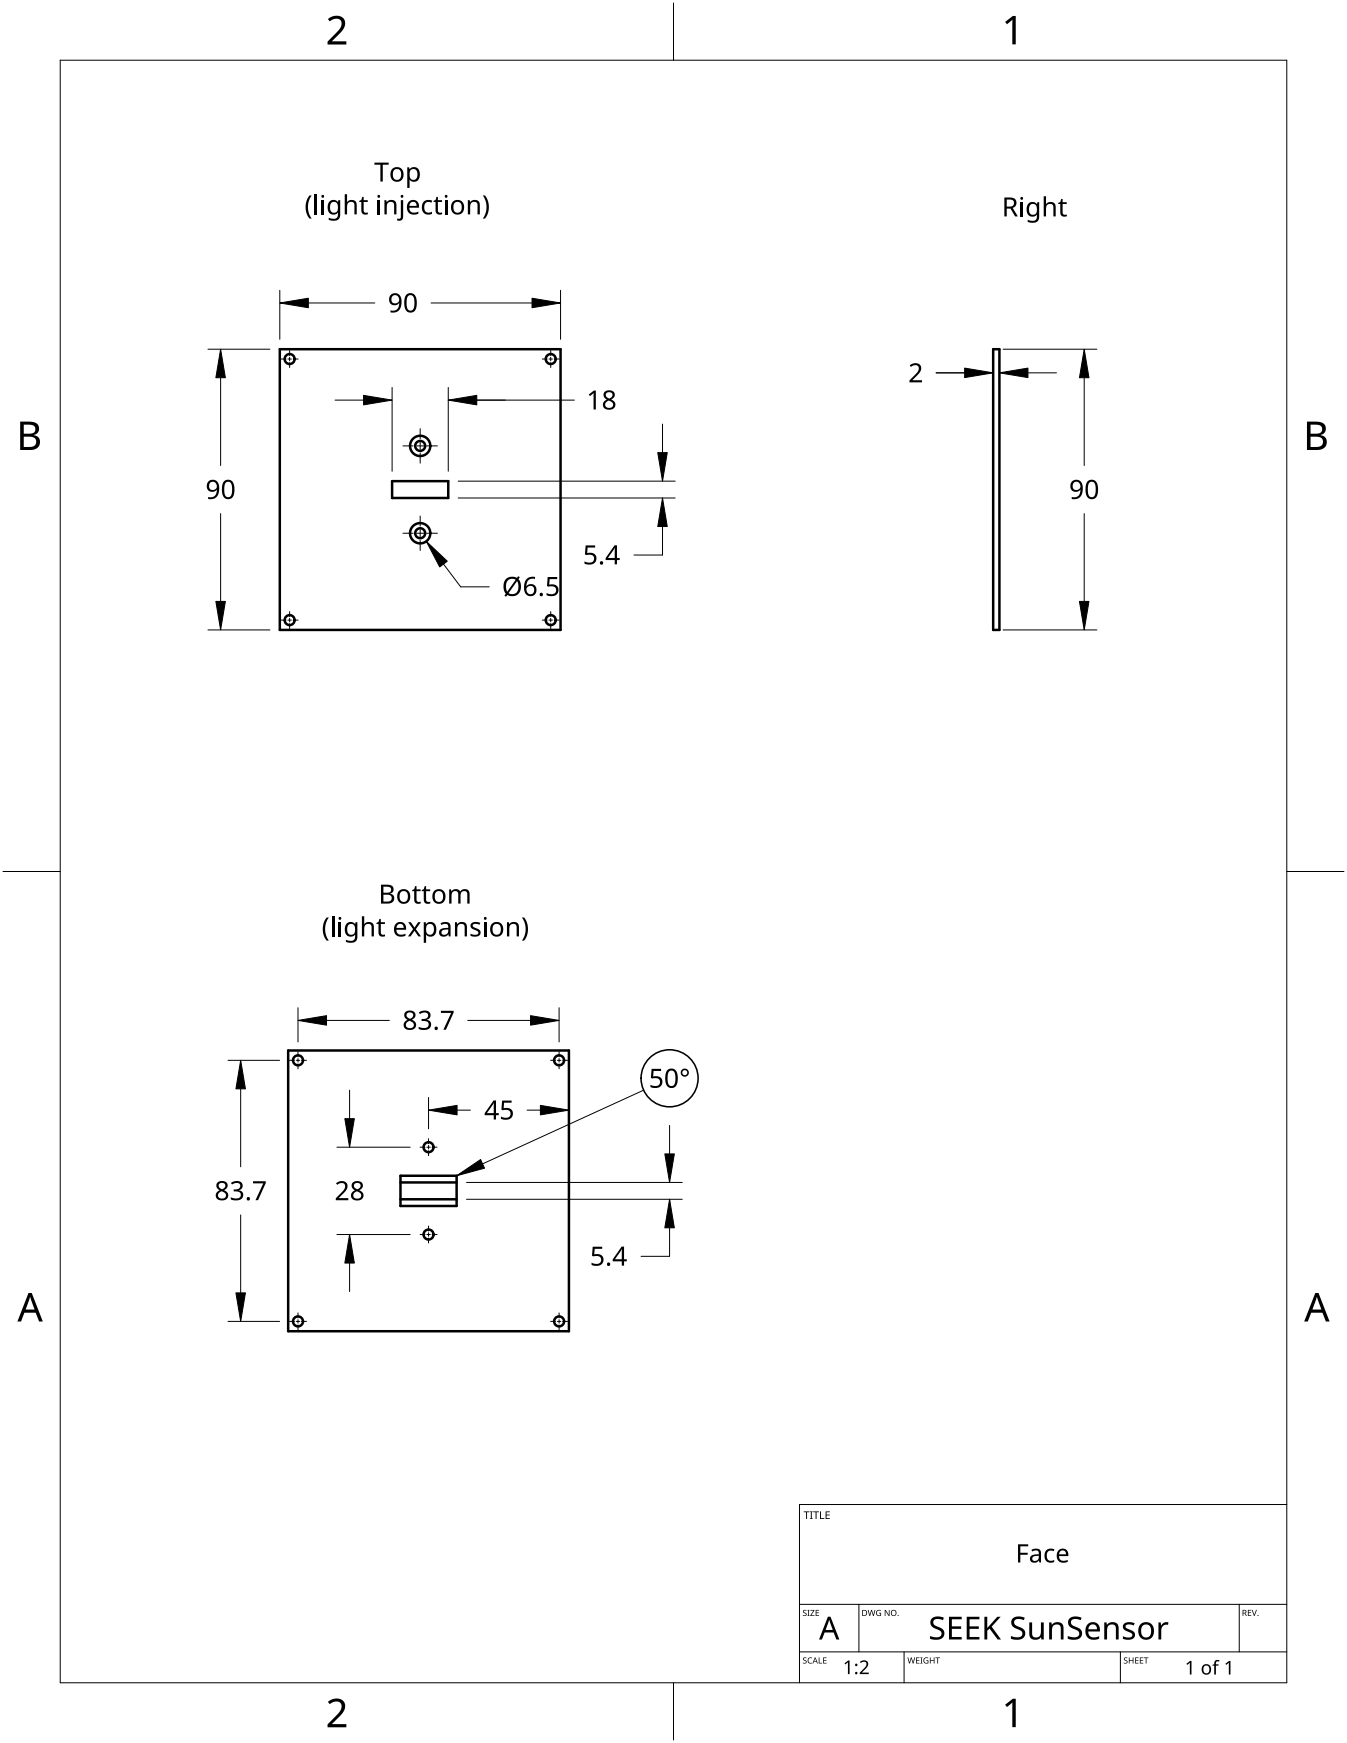
[picture p25: page 1]
