SEEK-Academy/sun-sensor-hardware/doc/3D_models/slit_sensor_face/drawings/SunSesnor Drawing - sensor array.pdf

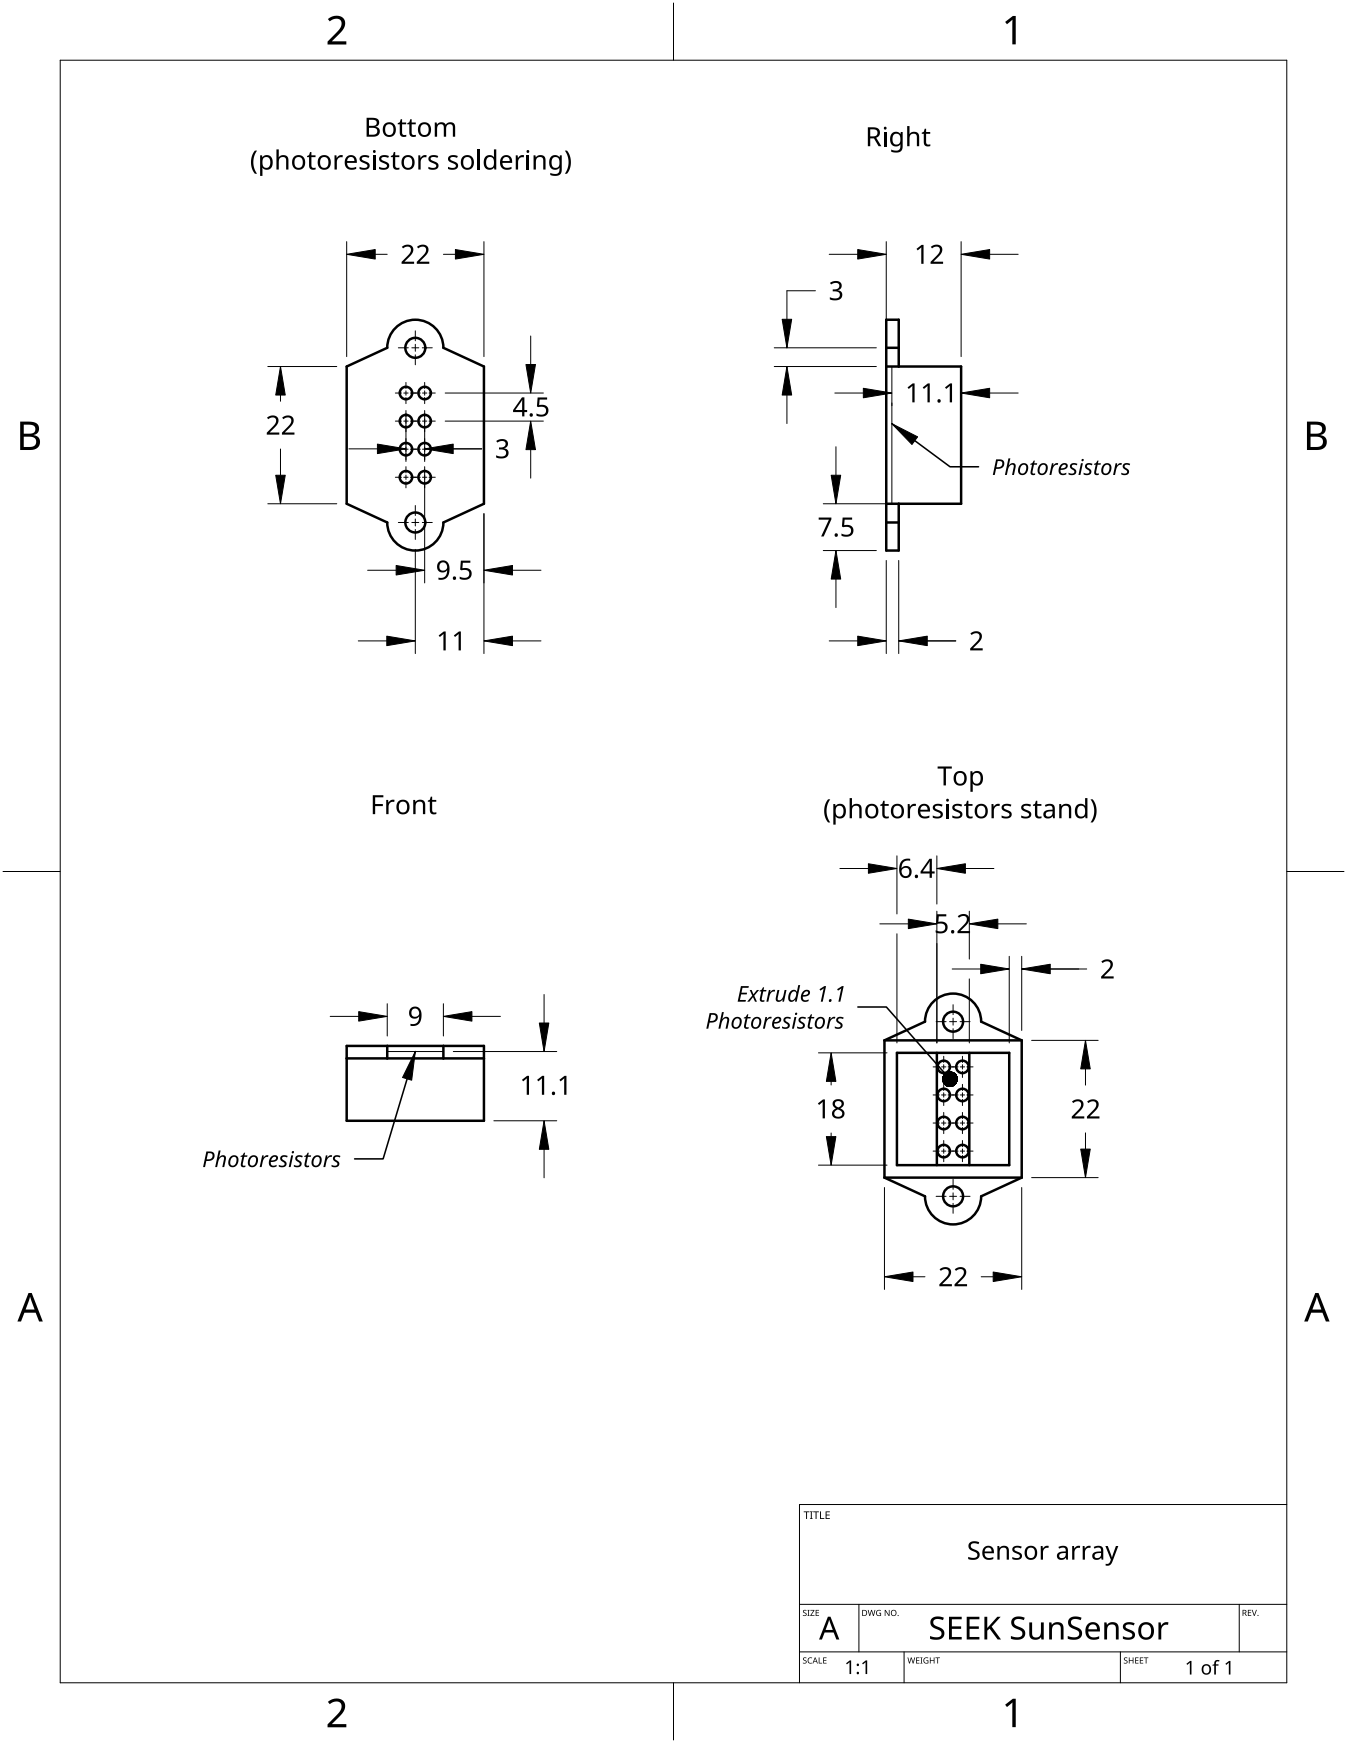
[picture p26: page 1]
