SEEK-Academy/sun-sensor-hardware/(commit log)

2024-11-22 feature: added cpputest framework
2024-12-03 feature: working arm-gcc compilation with cmake
2024-12-11 docs: added calculations and models v1-v5
    [Calculation.xlsx, Comparison of photoresist measurements - 20241130.xlsx, SunSensor - slit sensor face V1 - Face.3mf, SunSensor - slit sensor face V1 - Sensor array.3mf, SunSensor - slit sensor face V2 - Face.3mf, SunSensor - slit sensor face V2 - Face.stl, SunSensor - slit sensor face V2 - Sensor array.3mf, SunSensor - slit sensor face V2 - Sensor array.stl]
2024-12-12 docs: added electrical schematic
2024-12-12 docs: added bolts calculation
    [Calculation.xlsx]
2024-12-12 docs: added model v6
    [SunSensor - slit sensor face V6 - Face.3mf, SunSensor - slit sensor face V6 - Mount Separation Bottom.3mf, SunSensor - slit sensor face V6 - Mount Separation Top.3mf, SunSensor - slit sensor face V6 - Sensor array.3mf, SunSensor - slit sensor face V6 - all parts.3mf]
2024-12-16 fix: moved away from Eigen3 library
    [datatypes.h, main.cc]
2024-12-18 docs: created dedicated folder for slit sensor face
    [SunSensor - slit sensor face V1 - Face.3mf, SunSensor - slit sensor face V1 - Sensor array.3mf, SunSensor - slit sensor face V2 - Face.3mf, SunSensor - slit sensor face V2 - Face.stl, SunSensor - slit sensor face V2 - Sensor array.3mf, SunSensor - slit sensor face V2 - Sensor array.stl, SunSensor - slit sensor face V3 - Face.3mf, SunSensor - slit sensor face V3 - Sensor array.3mf]
2024-12-18 docs: added frame stick v1 model
    [SunSensor - frame stick V1 - All parts.3mf, SunSensor - frame stick V1 - Stick.3mf]
2024-12-18 docs: added slit sensor face lid v1 model
    [SunSensor - slit sensor face lid V1 - Face.3mf]
2024-12-21 wip: i2c implementation
2024-12-22 docs: added frame stick V2 and slit sensor face V7
    [Calculation.xlsx, SunSensor - frame stick V2 - All parts.3mf, SunSensor - frame stick V2 - Stick Lid.3mf, SunSensor - frame stick V2 - Stick.3mf, SunSensor - slit sensor face V7 - All parts.3mf, SunSensor - slit sensor face V7 - Face.3mf, SunSensor - slit sensor face V7 - Mount Separation Bottom.3mf, SunSensor - slit sensor face V7 - Mount Separation Top.3mf]
2024-12-27 docs: added internal platform v1 and updated 3d models readme
    [SunSensor - internal platform V1 - Platform.3mf]
2024-12-28 docs: added fram stick v3 and updated 3d models readme
    [SunSensor - frame stick V3 - All parts.3mf, SunSensor - frame stick V3 - Stick Lid.3mf, SunSensor - frame stick V3 - Stick.3mf]
2025-01-22 docs: added internal platform v3, update excel calculator and readme
    [Calculation.xlsx, SunSensor - internal platform V2 - All parts.3mf, SunSensor - internal platform V2 - Platform.3mf, SunSensor - internal platform V2 - Stabilizator.3mf]
2025-01-23 added internal platform v3, update excel calculator and readme
    [Calculation.xlsx, SunSensor - internal platform V3 - Platform - slicer.3mf, SunSensor - internal platform V3 - Platform.3mf, SunSensor - internal platform V3 - Stabilizator.3mf]
2025-02-18 docs: added internal platform v4, update excel and readme
    [Calculation.xlsx, SunSensor - internal platform V4 - Platform - slice1.3mf, SunSensor - internal platform V4 - Platform.stl, SunSensor - internal platform V4 - Stabilizator.stl]
2025-03-29 feat: add model assemblies with faces and platforms
    [Assembly - 3 faces and platforms.stl, Assembly - 3 faces.stl]
2025-04-01 feat: add slit sensor face drawings
2025-05-29 feat: add slit sensor face v8 calculations
    [Calculation.xlsx]
2025-06-09 feat: update calculation sheet, create SunSensor v2.0 parts: `Slit Sensor Face v8` and `Frame Stick v4`
    [Calculation.xlsx, SunSensor - PCB 50x70 tester.3mf, SunSensor - PCB 50x70 tester.stl, SunSensor - frame stick lid v4.stl, SunSensor - frame stick lid v4_detail_gpt.3mf, SunSensor - frame stick lid v4_detail_standard.3mf, SunSensor - frame stick lid v4_horizontal.3mf, SunSensor - frame stick lid v4_horizontal_supports.3mf]
2025-06-09 docs: add note about `Stick Lid` nut slot size problem to READNE
2025-06-17 feat: create SunSensor v2.1 pars: `Frame Cup v1`
    [SunSensor - frame cup v1.3mf, SunSensor - frame cup v1.stl]
2025-06-21 feat: create SunSensor v2.2 `Slit Sensor Face v9` and fit PCB 46x61 tester
    [SunSensor - PCB 46x61 tester.3mf, SunSensor - PCB 46x61 tester.stl, SunSensor - slit sensor face v9 - Face.3mf, SunSensor - slit sensor face v9 - Face.stl, SunSensor - slit sensor face v9 - Separator.stl]
2025-07-03 feat: create SunSensor v2.3 with parts: `Slit Sensor Face v10` and `Frame Cup v2`
    [SunSensor - frame cup v2.3mf, SunSensor - frame cup v2.stl, SunSensor - slit sensor face v10 - Face.3mf, SunSensor - slit sensor face v10 - Face.stl, SunSensor - slit sensor face v10 - Separator.3mf, SunSensor - slit sensor face v10 - Separator.stl]
2025-07-15 feat: create `PCB 50x70 v2 tester`
    [SunSensor - PCB 50x70 v2 tester.3mf, SunSensor - PCB 50x70 v2 tester.stl]
2025-07-15 feat: add image visualization for `PCB 50x70 v2`
2025-08-05 feat: add image visualization for `PCB 40x60 FR v1` and `PCB 60x80 STM v1`
2026-03-09 feat: add washer model and update frame cup model
    [SunSensor - frame cup v2.3mf, Washer M1.8 6x0.4mm (30 psc.).3mf, Washer M1.8 6x0.4mm.3mf, Washer M1.8 6x0.4mm.stl]
2026-03-20 feat: update parts for sun sensor 2.4
    [SunSensor - frame cup v3.3mf, SunSensor - holder v1.3mf, SunSensor - holder v1.stl, SunSensor - slit sensor face v10 - Face.3mf, SunSensor - slit sensor face v11 - Face.3mf, SunSensor - slit sensor face v11 - Separator.3mf]
2026-04-08 feat: update PCB with ADC schema
2026-04-09 feat: add photo of PCB without ADC
